openeew/openeew-sensor/pcb/legacy/eagle/openeew_sensor.pdf

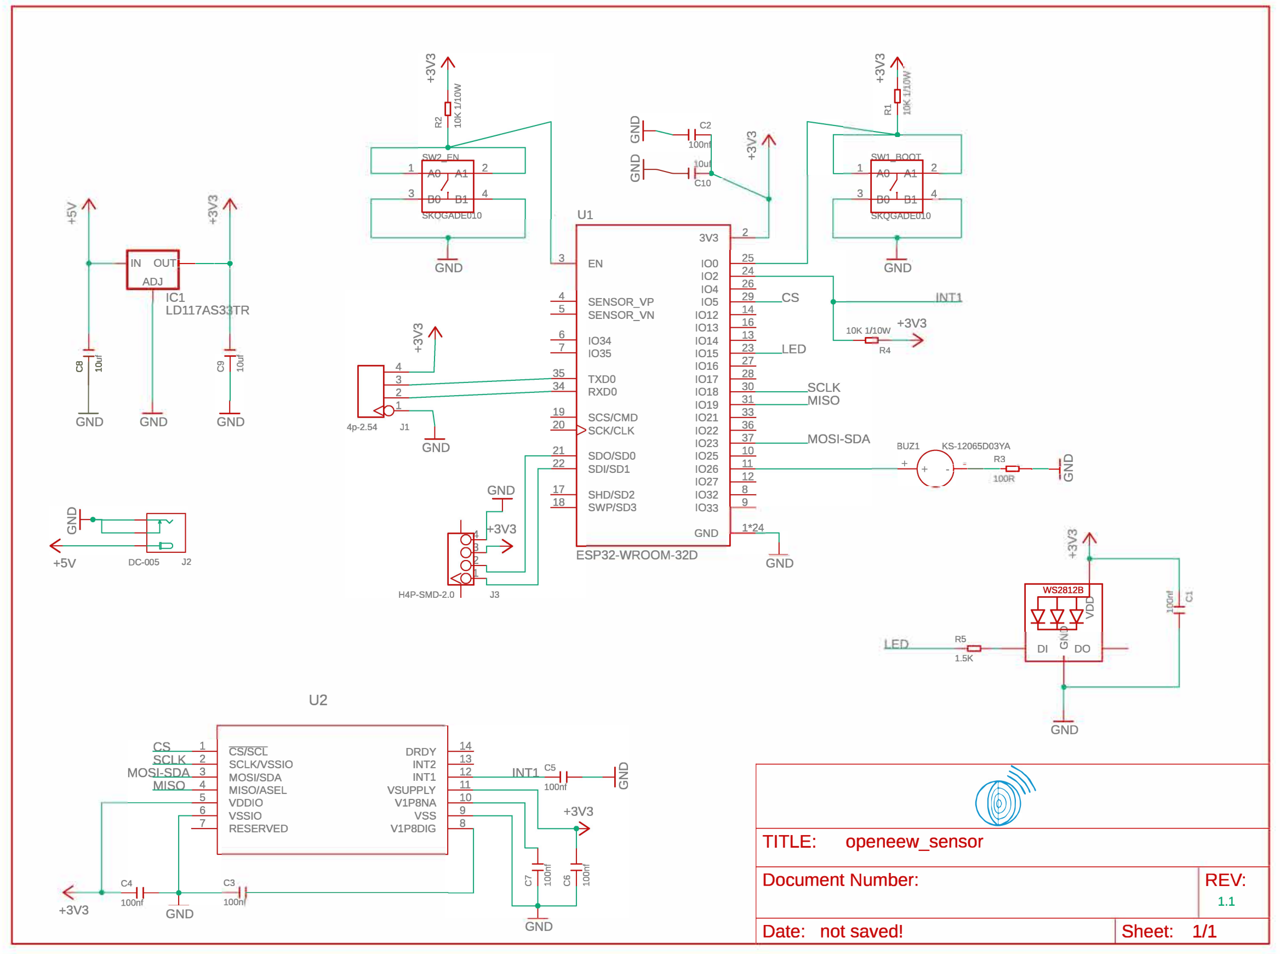
[picture p3: page 1]

'³

T?
1

GND

+5V

+3V3

IN OUTI---
ADJ

ICl
LD117AS3 TR

GND

DC-005 | J2

GND

GND

c::s7Scr
SCLK/VSSIO
MOSI/SDA
MISO/ASEL
VDDIO
VSSIO
RESERVED

C3
lOOn

U2

1

3

GND

DRDY
INT2
INTl
VSUPPLY
VlPSNA
vss
VlPSDIG

3

GND

GND

0 Ou 13 | ClO

Ul
3V3
EN | 100
| 102
| 104
SENSOR_VP | 105
SENSOR_VN | 1012
| 1013
1034 1014
1035 1015
| 1016
TXD0 | 1017
RXD0 | 1018
| 1019
SCS/CMD | 1021
SCK/CLK | 1022
| 1023
SDO/SD0 | 1025
SDI/SDl | 1026
| 1027
SHD/SD2 | 1032
SWP/SD3 | 1033
| GND

ESP32-WROOM-32D

"'

"'
+

2

1*24

GND

1

3

GND

+3V3 lOK 1/lOW

R4

0

## ¹⁻"---C>⁻--t 13

RS
DI C!> DO

1.5K

GND
ct

## TITLE: openeew _ sensor

## Document Number:

## Date: not saved!

REV:
1.1

## Sheet: 1/1
