openeew/openeew-sensor/images/case-bottom.jpg

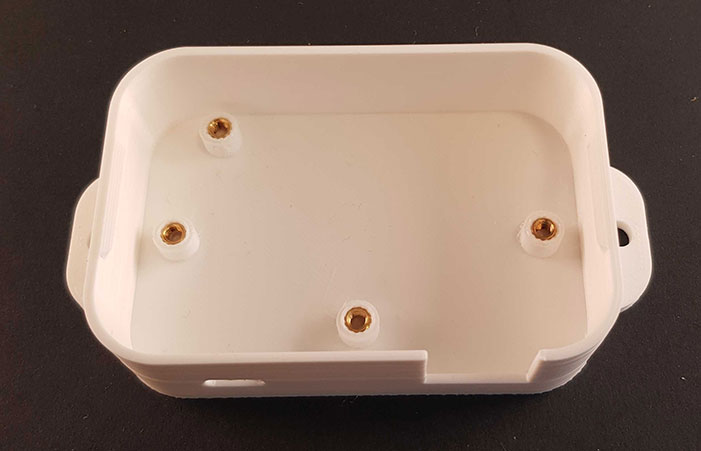
images/case-bottom.jpg
