openeew/openeew-sensor/images/case-lid.jpg

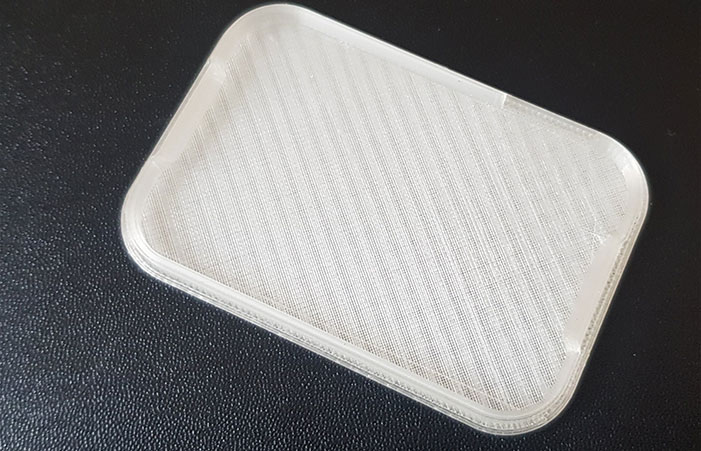
images/case-lid.jpg
