openeew/openeew-sensor/images/PCB-3d.png

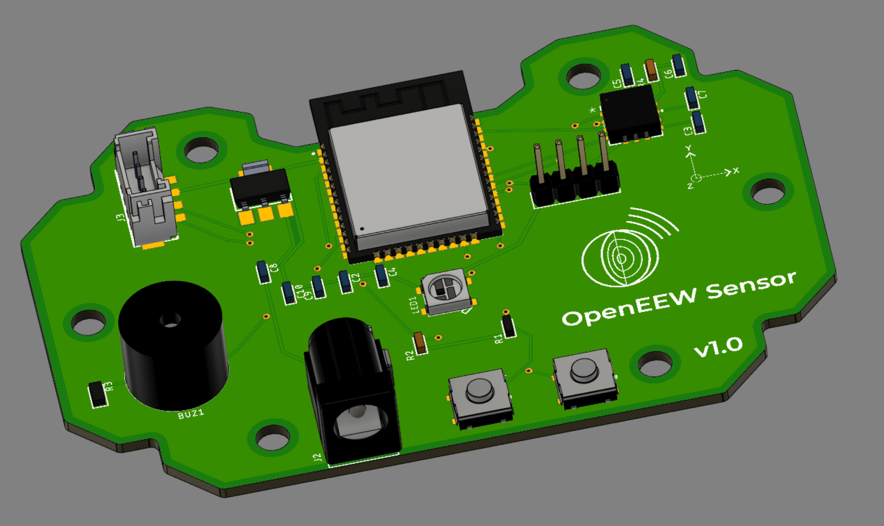
images/PCB-3d.png
