openeew/openeew-sensor/images/pcb-openeew.PNG

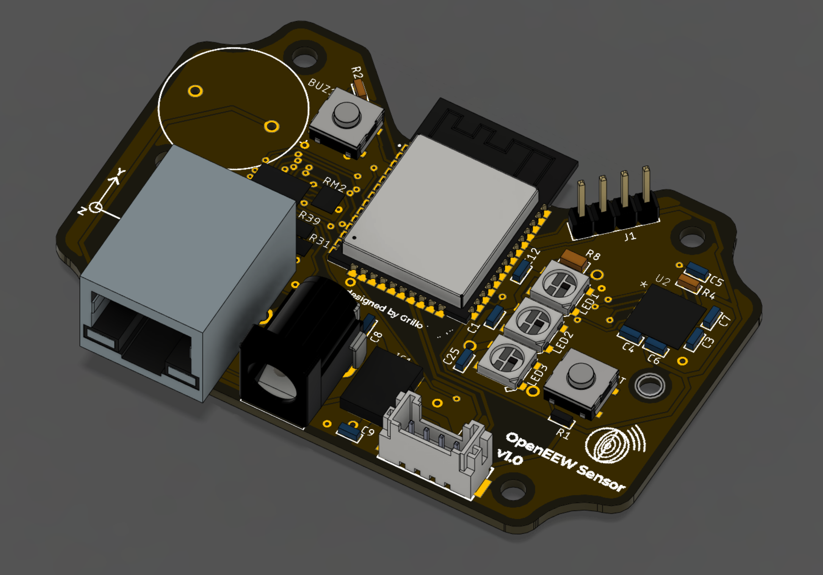
images/pcb-openeew.PNG
