openeew/openeew-sensor/images/platformio-spiffs.png

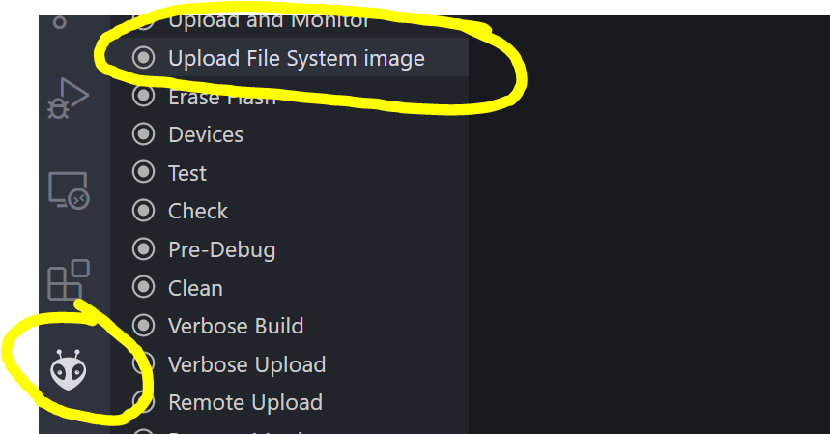
images/platformio-spiffs.png
