openeew/openeew-sensor/images/sensor-bubble-level.jpg

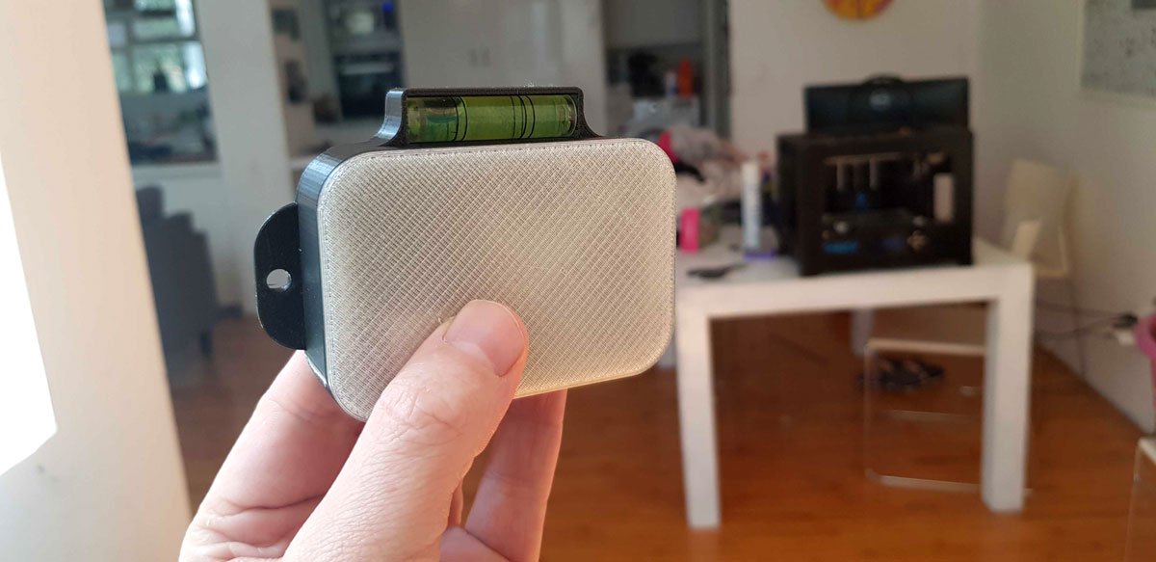
images/sensor-bubble-level.jpg
