openeew/openeew-sensor/images/sensor-case-closed.jpg

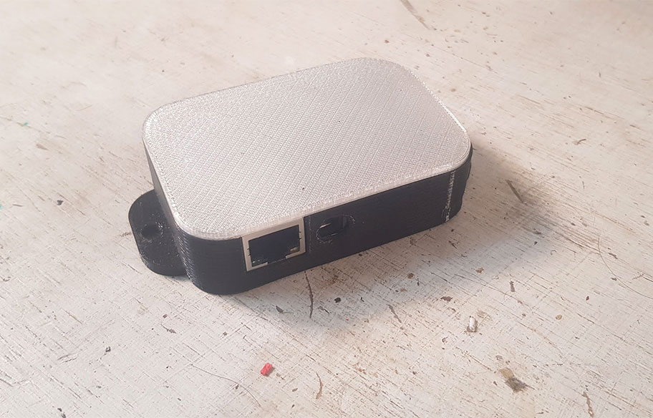
images/sensor-case-closed.jpg
