openeew/openeew-sensor/images/sensor-case-open.jpg

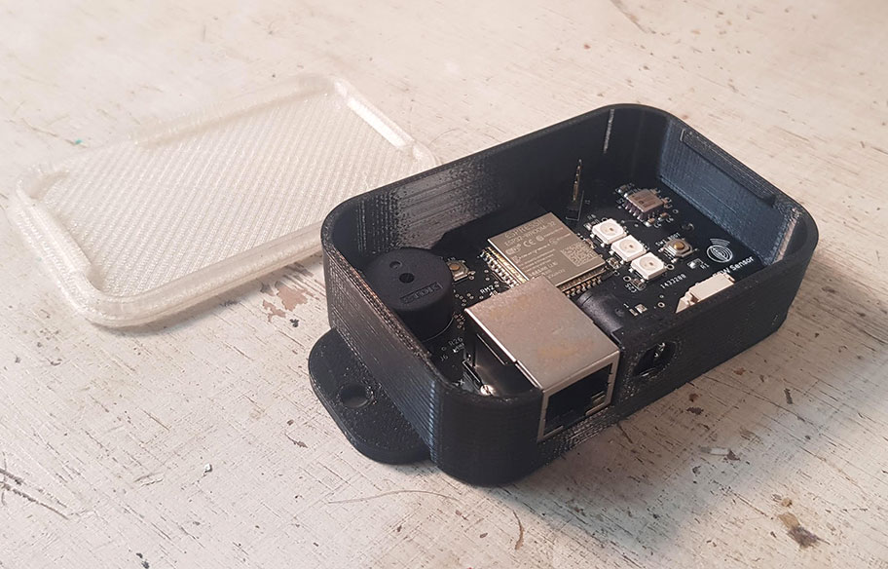
images/sensor-case-open.jpg
