openeew/openeew-sensor/images/threaded-insert.jpg

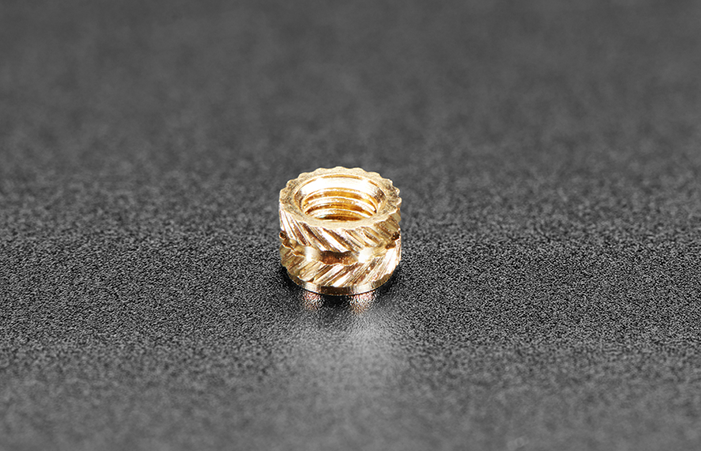
images/threaded-insert.jpg
