openeew/openeew-sensor/images/sensor-install.jpg

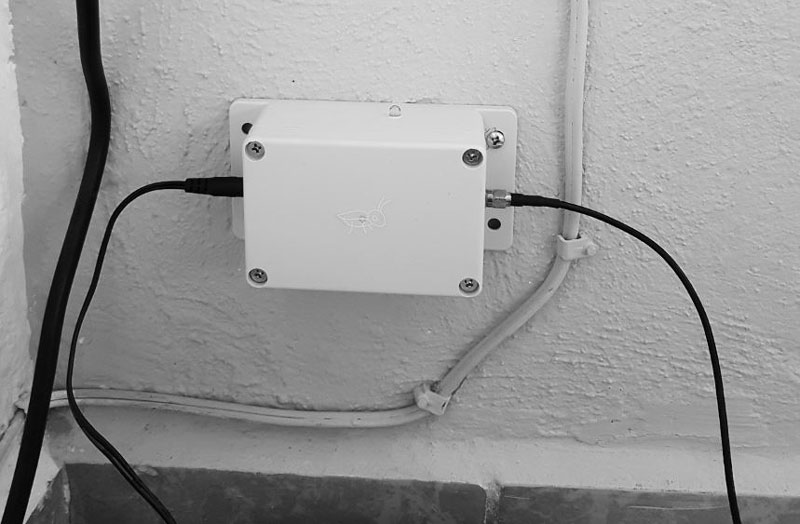
images/sensor-install.jpg
