openeew/openeew-sensor/(threads)

Thread 2 (2020-08-10):

Create new firmware branch with 'edge' processing that significantly reduces telemetry

andygrillo, 2020-08-10:
The current firmware transmits all accelerations (31.25 or 125hz) every second to the MQTT server. However more than 99% of this is not useful data because it include non-earthquake accelerations. Reducing the telemetry would also allow for new connectivity options such as LTE and CAT-M1 where every Kb sent has a cost, and therefore would open up new opportunities for installing dense networks in remote areas.

If you can help, please create a new branch for the existing [firmware](https://github.com/openeew/openeew-sensor/tree/master/firmware). This will contain many of the same features such as:
- reading FIFOs from the ADXL355
- a running average to maintain a zero-g offset
- mqtt transmission (if going cellular we could use UDP instead as the line will be secure)
- NTP functions

However it will also have new features:
- on every second (1 fifo@ 31.25hz sample rate, or 4 fifos@125hz sample rate), it will perform an STA/LTA calculation which divides the last second of data for each axis with the last 10 (to be a variable) seconds of data for each axis.
- if the output of the STA/LTA value is > x (variable to be defined in config or by MQTT subscribe on boot), then an event is determined, and the maximum acceleration ( pga ) is taken from the previous 1 second of data.
- the pga value is then added to a JSON and sent to the MQTT server with the `trigger` topic:
```
{"device_id":XXX, "lat":XXX, "lon"XXX, "time":XXX, "pga":XXX}
```

johnwalicki, 2020-12-10:
Vaclav, RUWO and John met on 12/09/2020 to discuss the STA/LTA algorithm implementation on how to detect quakes.
Here are some minutes of that discussion:
Attendees: @Vaclav Kuna @RUWO @John Walicki

- Vaclav reviewed his Python STA/LTA algorithm implementations (there is a loop technique and a Matrix math technique)
- The board needs to store 10 seconds of data [x,y,z] in some array.
- Run the algorithm on new readings (32 samples from the last second) and the prior 10 seconds.  So its really 11 seconds of data.
- Better to run the algorithm on each of the 32 new values against the prior array of values.
- John suggested that we don't think of the prior 10 seconds of data in terms of seconds, just a queue of 320 values. There are a variety of example First In First Out queue implementations on StackOverflow.
- If the result is greater than a threshold ( 3 is a good compromise but might be different for different sensors),  send the prior 10 seconds to the cloud and start sending real time accelerometer data for the next 5 seconds
- We discussed being able to adjust the Threshold via a MQTT topic on a per sensor basis.  If one sensor is located in a "noisy" environment and is throwing lots of false positives, we could tell it to up its threshold via a message sent down from the cloud.  Tabled as an advanced feature.
- Since John received a new board from Andy today, he could possibly send his old board to Belgium.  The old board has a working ESP32 and ADXL355 but other components are flakey.  Wout only needs the ESP32 and ADXL355.
- Split the project into several steps.

1. - Implement a FIFO queue that stores/manages the prior 320 readings (10 seconds)
2. - Implement a function which sends this bigger block of data via MQTT to the cloud.  (Current implement is sending 1 second at a time and would need to be modified with larger buffers)
3. - Iterate on the STA/LTA algorithm
4. - When the 10 second block of data arrives in the cloud, store it somewhere, start the alarm process?

johnwalicki, 2020-12-15:
Firmware version 1.3.0 branch is open.  I am working on the STA/LTA algorithm in v1.3.0
 https://github.com/openeew/openeew-sensor/tree/version130

johnwalicki, 2020-12-16:
Sections of code required to implement this feature are landing in the version130 branch
https://github.com/openeew/openeew-sensor/commit/6edafb81ef008fdaedcc5c6b31e546a6eef7ee26
https://github.com/openeew/openeew-sensor/commit/abc14a942d50beb9063b6852034a630a77cf11ad

johnwalicki, 2020-12-23:
When sending 10 seconds of accelerometer data to the cloud, it should really include timestamps.  Currently the two patches in this feature just store the prior 10 seconds of accelerometer X,Y,Z data in a FIFO queue of 320 readings ( 32 readings/second x 10 seconds ).  Time is relative to "now", there's no absolute timestamp. When we transmit and subsequently store the data in the cloud database for later analysis, there's no reference point.  I need to add timestamps to the FIFO queue.

Note that the 32 readings are sampled once per second so the timestamp accuracy is going to be slightly off. Since the order of samples is preserved, the analysis could spread the samples "across" that trailing second.

Note its a trailing second.  the program will record the timestamp when it reads the ADXL355 buffer (which contained the prior second's worth of data)  That timestamp will be the prior 32 samples.

andygrillo, 2020-12-23:
To be discussed with Vacalv, but potentially we can omit the device
timestamp and add a timestamp when its been ingested in the cloud. As
device>cloud latency is typically less than 1/2s, it should be ok.

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

--
Andres Meira
*m* +52 (55) 12246468
*skype *andresmeira

johnwalicki, 2021-02-19:
Firmware v1.3.0 has been published
This Issue has been closed via https://github.com/openeew/openeew-sensor/pull/61

Closed 2021-02-19.

Thread 3 (2020-08-12):

BOM and PCB files missing

frankenstein91, 2020-08-12:
As far as I can see, only the circuit diagram is currently available, but the BoM and PCB files are still missing.
But these files are already referred to in the documentation and on the website.

krook, 2020-08-12:
@andygrillo

andygrillo, 2020-08-12:
@frankenstein91 @krook yes sorry we only had a PDF schematic. Please look now- I added the eagle files :)

andygrillo, 2020-08-12:
For now you can generate the BOM from the eagle schematic. I will clean up the BOM I have here and upload later today.

hildogjr, 2020-08-13:
How about using [KiCad](https://kicad-pcb.org/) as free schematic/layout software? There is also [tool for cost BOM](https://pypi.org/project/kicost/) .

andygrillo, 2020-08-13:
Yes I suppose we should stick to open source (although eagle is free for this size of board).

we used eagle because we were comfortable, but if you are ok with doing this board in Kicad, that would be awesome.

chronopoulos, 2020-08-13:
+1 for kicad

gimbas, 2020-08-13:
Would there be interest in a project conversion to Kicad? I want to contribute.

andygrillo, 2020-08-13:
If you are willing to do this (great!), I will list out here my findings from testing the current board that we just got  back from China. The important functions seem good (still testing), i.e. ESP32, UART interface, Ethernet, and most importantly SPI connection with ADXL355.

However would be good to take a look at the WS2812b circuit as I'm not able to get anything other than white right now using the Neopixels sample code, and there is a flicker with the brightness.

The UART header + 5v dc jack should probably be replaced with a USB port (type C). The issue is that some follks may not have a 3.3v FTDI module lying around - will make programming easier.

gimbas, 2020-08-13:
Starting to work on it right away, there are some things that warrant some discussion, where should that happen?

krook, 2020-08-13:
@gimbas The #sensors channel in Slack would probably be the right place.

hildogjr, 2020-08-13:
I would propose to add "manf#" field to each part for the Manufacture Part Number. We can use it by [KiCost](https://pypi.org/project/kicost/) for generate a automatic cost BOM.

andygrillo, 2020-08-29:
> I would propose to add "manf#" or "mpn" field to each part for the Manufacture Part Number. We can use it by [KiCost](https://pypi.org/project/kicost/) for generate a automatic cost BOM.

Thats a great idea @hildogjr  - please can you suggest this in a new issue ?

Closed 2020-08-31.

Thread 4 (2020-08-12):

Add method for including latitude and longitude of sensor to msgs for /device topic

andygrillo, 2020-08-12:
In previous iterations of the Grillo sensor we included GPS modules. However we have not included them in the sensor hardware to save cost, to make it easier to install away from windows, and because NTP time is accurate enough for EEW.

However we now need a new way to pass on the location of each sensor in the `/device` topic message.

I suggest we avoid using Google Geolocation API as this incurs a cost. Instead we can pass on the lat/lon coordinates using the ESP32 smart config protcol. This is already used to send wifi credentials - why cant it also be used to send lat/lon coordinates of phone ?

Potentially we can create a new iteration of the ESPTouch mobile app which sends this data using https://pub.dev/packages/esptouch_flutter, and then modify the firmware to receive these new values.

johnwalicki, 2020-11-12:
I found a simple API that will give you Lat,Lng
https://ipstack.com/documentation
I signed up for a free apikey that allows for 10K msgs / month
The API  was simple to call and it returns a json object that includes Lat,Lng
http://api.ipstack.com/check?access_key=<myapikey>

johnwalicki, 2020-11-12:
I envision, at every device powerup, it calls this location API and figures out where it is.
Sends a "Device Activated" message to some restful "Onboarding" interface in the Cloud.
The message includes WiFi, Ethernet mac addresses and Lat,Lng
The response from our centralized "Onboarding" API would include the MQTT host it should connect to.
"Oh, your device is in [Nepal,New Zealand,Mexico,Carribean,etc] return a Watson IoT Platform MQTT instance close to me"

andygrillo, 2020-11-12:
Sounds great, excellent way to route devices to endpoints.

Ill look at this servie tomorrow. My concern is if it works simply by the
ip address. We tries this before and it regularly got the address wrong by
hundreds of meters and in one case in another state. This would have a big
impact on the detection. But maybe we coukd get the user to confirm the
address somehow?

On Wed, Nov 11, 2020, 11:07 PM John Walicki <notifications@github.com>
wrote:

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

johnwalicki, 2020-11-12:
Agree that it might not be 100% accurate but it gets really close.  In my case, it put the map pin directly in front of my house.

johnwalicki, 2020-11-23:
A mobile application might need to assist in more accurate geolocation.  In the OpenEEW #apps slack channel, we've been discussing using Flutter / SmartConfig / Device registration panels that can send email and location to the cloud so that we can link the device WiFi mac address to an owner / place.

johnwalicki, 2020-12-13:
The mobile OpenEEW Provisioning app sends the smartphone GPS coords as part of the user details registration.
This information is stored in the Cloudant DB.
See https://github.com/openeew/openeew-provisioner/blob/main/PROVISIONING.md

The possible risk is that devices get activated somewhere NOT where they will be positioned.
@andygrillo  is that sufficient?

andygrillo, 2020-12-13:
I suspect this is fine. Later on we could discuss adding a verification
step where the address is sent back to the user, or the user has to confirm
the location on the dashboard ?

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

--
Andres Meira
*m* +52 (55) 12246468
*skype *andresmeira

johnwalicki, 2020-12-13:
Thinking through the wifi set-up, the device might be activated, using the Mobile app, on one network,  that location would be written to Cloudant db. Then,  when the device moves, the new wifi network said/password will likely be different. The mobile app would be used, call SmartConfig and also adjust/overwrite the device location in the Cloudant db.

Closing issue

Closed 2020-12-13.

Thread 6 (2020-08-13):

PoE module plugin

andygrillo, 2020-08-13:
Would be good to have the option to add a PoE module that could be plugged in. This would allow for installation in commercial environments with only an ethernet cable connecting the sensor.

I know its been discontinued, but as an example this seemed to work well :
https://github.com/particle-iot/ethernet-wing

perigoso, 2020-09-06:
I never played with PoE, so I was unfamiliar with it. But I've been doing some research and learning about it so I might be able to implement it in the near future, for now though  I think i detected our first problem with it, our current Ethernet connector is not made with PoE in mind so I think it's not possible to do it with it, we need to look for an alternative.

andygrillo, 2020-09-06:
Good find. Our ethernet circuit is based on an Olimex ESP32 board. I
believe they also have a PoE version so I'll see what components they use
there.

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

perigoso, 2020-09-06:
Olimex does have some very good reference material, i think this is a good guideline: [ESP32-POE-ISO](https://www.olimex.com/Products/IoT/ESP32/ESP32-POE-ISO/open-source-hardware)

andygrillo, 2020-09-07:
Oh very nice :) They have kicad files also https://github.com/OLIMEX/ESP32-POE-ISO/tree/master/HARDWARE/ESP32-PoE-ISO-Rev.D

Thread 7 (2020-08-17):

Send meta data message on boot to /device topic

andygrillo, 2020-08-17:
When the device boots up, it should send a message to `device` MQTT topic containing device ID, latitutde, longitude, firmware version, device type and time.

An example would be:
```{device_id: 2351n2x55, latitude: 19.35, longitude: -99.14, firmware_version: 1.2, device_type: esp32, time_entered: 1597685615}```

This message will become a row in the database - see the corresponding table structure [here](https://github.com/openeew/openeew-detection/blob/master/init_db.sql).

johnwalicki, 2020-11-16:
I've added an OpenEEW Device Activation endpoint to the firmware.  This isn't a MQTT message because the board doesn't know where to send its MQTT data until the endpoint replies with the MQTT broker.   The HTTP post from the board to the endpoint running in IBM Cloud, includes
```{"macaddress":"112233445566","lat":40,"lng":-74,"firmware_device":"1.0.0"}```

johnwalicki, 2020-11-16:
Not exactly the original request, but very close to the intended purpose.  I think this GitHub issue can be closed via
https://github.com/openeew/openeew-sensor/pull/43
https://github.com/openeew/openeew-sensor/pull/44
https://github.com/openeew/openeew-sensor/pull/45

johnwalicki, 2020-11-16:
The IBM Cloud side of the new OpenEEW Device Activation endpoint stores the new device details in a Cloudant DB and in Watson IoT Platform metadata.

johnwalicki, 2020-11-23:
Closing issue - implemented via the Device Activation techniques described above.

Closed 2020-11-23.

Thread 8 (2020-08-17):

Change RMII pins in Kicad layout

andygrillo, 2020-08-17:
The TXD1 pin from the ESP32 should go to the TXD1 pin in the LAN8720 module.
Similarly, the TXD0 pin should also go to the TXD0 pin in the LAN8720.

Currently we have these crossed:
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

Its not possible to reassign these pins in code because the ESP32 has a fixed RMII bus, so the wiring must be done correctly.

perigoso, 2020-08-17:
This was one thing in particular that i wanted to ask when i ported the schematic, makes sense now.

andygrillo, 2020-08-17:
Yes, was our mistake. Its a shame because we wanted to test the LAN8720

perigoso, 2020-08-19:
Check If this is the only erroneous connection in the RMII

Closed 2020-08-19.

Thread 12 (2020-08-29):

Rev 1.0 hardware issues

perigoso, 2020-08-29:
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

This is issue is meant to keep track of these issues and related fixes

andygrillo, 2020-08-29:
Great idea. Thanks @perigoso this way it doesn't get lost in slack :)

perigoso, 2020-08-31:
I wanted to ask about this circuit? what exactly is it trying to achieve, and where did you get it from?

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

perigoso, 2020-08-31:
Changed the level shifting on the WS2812B LEDs to a schmit-trigger buffer, this avoids the inversion of the data line, and should provide clean edges (i believe one these was the cause for the issues).

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

perigoso, 2020-08-31:
Changed the Buzzer driving circuit

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

@andygrillo If you want to test the buzzer with the current revision try changing the resistor in series with the buzzer for a 0 ohm / short, and change the transistor base resistor for a value around 1k, you should be able to get some sound out of it.

andygrillo, 2020-08-31:
> I wanted to ask about this circuit? what exactly is it trying to achieve, and where did you get it from?
>

Hi @perigoso , the guy who designed this based the ethernet circuit on the Olimex esp32 board: https://www.olimex.com/Products/IoT/ESP32/ESP32-EVB/  - here you can find the link to the schematic pdf which he worked from.

andygrillo, 2020-09-03:
@perigoso when you receive the board, would you be capable rerouting 2 RMII connections between the LAN8710 and ESP32 ?

I think we need to cut traces between TXD1 > TXD0, and TXD0 > TXD1, then connect with new wires so that TXD1 > TXD1 and TXD0 > TXD0 ?

I have tried but the traces are very small and I don't have a microscrope/my eyes aren't good enough....

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

perigoso, 2020-09-03:
@andygrillo I was already planning on doing so! should not be an issue

andygrillo, 2020-09-03:
If you success pls tell me how you did it! its so small I can't even use a normal solid wire between the pads

andygrillo, 2020-09-03:
Also, you'll need an FTDI 3.3v to program it, which I suspect you would already have

gareth2020, 2020-09-11:
We can work with the Plated Though Holes (PTH)s on the underside.
3 tracks are visible on the underside from PTHs under the esp32 to PTHs near the PHY.
We can bare two of those tracks with a scalpel.
We can cut the two tracks with a scalpel and then solder new wires to cross over the connections.

Numbering the holes under the esp32 from top to bottom as h1,h2,h3,
Numbering the holes next to the PHY from top to bottom as p1,p2,p3

On V1.0 pcb
h1 is connected to p1 by a long track
h2 is connected to p2 by a long track
h3 is connected to p3 by a long track

h1 does not matter
h2 seems to be connected to pin 36 of esp32 (IO22 = EMAC_TXD1)
h3 seems to be connected to pin 31 of esp32 (IO19 = EMAC_TXD0)

In the following part of the top view:
p1 is connected to pin 21 of the PHY (TXEN)
p2 is connected to pin  22 of the PHY (TXD0) 
p3 is connected to pin  23 of the PHY (TXD1)
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

perigoso, 2020-09-22:
Quick update, after the rework the board seems to work as expected
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

```
ETH Disconnected
ETH Connected

ETH MAC: 24:6F:28:CC:E8:A3, IPv4: 192.168.1.69, FULL_DUPLEX, 100Mbps
connecting to google.com
HTTP/1.1 301 Moved Permanently
Location: http://www.google.com/
Content-Type: text/html; charset=UTF-8
Date: Tue, 22 Sep 2020 00:07:10 GMT
Expires: Thu, 22 Oct 2020 00:07:10 GMT
Cache-Control: public, max-age=2592000
Server: gws
Content-Length: 219
X-XSS-Protection: 0
X-Frame-Options: SAMEORIGIN

<HTML><HEAD><meta http-equiv="content-type" content="text/html;charset=utf-8">
                                                                              <TITLE>301 Moved</TITLE></HEAD><BODY>
                                                                                                                   <H1>301 Moved</H1>
               The document has moved
                                     <A HREF="http://www.google.com/">here</A>.
</BODY></HTML>
closing connection
```

andygrillo, 2020-09-22:
great work!

andygrillo, 2020-09-22:
for reference, here is the ethernet test program:
```
/*
    This sketch shows how to configure different external or internal clock sources for the Ethernet PHY
*/
#include <ETH.h>
/*
   * ETH_CLOCK_GPIO0_IN   - default: external clock from crystal oscillator
   * ETH_CLOCK_GPIO0_OUT  - 50MHz clock from internal APLL output on GPIO0 - possibly an inverter is needed for LAN8720
   * ETH_CLOCK_GPIO16_OUT - 50MHz clock from internal APLL output on GPIO16 - possibly an inverter is needed for LAN8720
   * ETH_CLOCK_GPIO17_OUT - 50MHz clock from internal APLL inverted output on GPIO17 - tested with LAN8720
*/
#ifdef ETH_CLK_MODE
#undef ETH_CLK_MODE
#endif
#define ETH_CLK_MODE ETH_CLOCK_GPIO17_OUT
//#define ETH_CLK_MODE ETH_CLOCK_GPIO0_IN
//#define ETH_CLK_MODE ETH_CLOCK_GPIO0_OUT
// Pin# of the enable signal for the external crystal oscillator (-1 to disable for internal APLL source)
#define ETH_POWER_PIN   -1
// Type of the Ethernet PHY (LAN8720 or TLK110)
#define ETH_TYPE        ETH_PHY_LAN8720
// I²C-address of Ethernet PHY (0 or 1 for LAN8720, 31 for TLK110)
#define ETH_ADDR        0
// Pin# of the I²C clock signal for the Ethernet PHY
#define ETH_MDC_PIN     23
// Pin# of the I²C IO signal for the Ethernet PHY
#define ETH_MDIO_PIN    18
static bool eth_connected = false;
void WiFiEvent(WiFiEvent_t event) {
  switch (event) {
    case SYSTEM_EVENT_ETH_START:
      Serial.println("ETH Started");
      //set eth hostname here
      ETH.setHostname("esp32-ethernet");
      break;
    case SYSTEM_EVENT_ETH_CONNECTED:
      Serial.println("ETH Connected");
      break;
    case SYSTEM_EVENT_ETH_GOT_IP:
      Serial.print("ETH MAC: ");
      Serial.print(ETH.macAddress());
      Serial.print(", IPv4: ");
      Serial.print(ETH.localIP());
      if (ETH.fullDuplex()) {
        Serial.print(", FULL_DUPLEX");
      }
      Serial.print(", ");
      Serial.print(ETH.linkSpeed());
      Serial.println("Mbps");
      eth_connected = true;
      break;
    case SYSTEM_EVENT_ETH_DISCONNECTED:
      Serial.println("ETH Disconnected");
      eth_connected = false;
      break;
    case SYSTEM_EVENT_ETH_STOP:
      Serial.println("ETH Stopped");
      eth_connected = false;
      break;
    default:
      break;
  }
}
void testClient(const char * host, uint16_t port) {
  Serial.print("\nconnecting to ");
  Serial.println(host);
  WiFiClient client;
  if (!client.connect(host, port)) {
    Serial.println("connection failed");
    return;
  }
  client.printf("GET / HTTP/1.1\r\nHost: %s\r\n\r\n", host);
  while (client.connected() && !client.available());
  while (client.available()) {
    Serial.write(client.read());
  }
  Serial.println("closing connection\n");
  client.stop();
}
void setup() {
  Serial.begin(115200);
  WiFi.onEvent(WiFiEvent);
  ETH.begin(ETH_ADDR, ETH_POWER_PIN, ETH_MDC_PIN, ETH_MDIO_PIN, ETH_TYPE, ETH_CLK_MODE);
}
void loop() {
  if (eth_connected) {
    testClient("google.com", 80);
  }
  delay(10000);
}```

perigoso, 2020-09-22:
I got the buzzer to output sound, i have no way to measure but it's not too loud, some optimizations can be done.

[I posted a video on slack](https://openeew.slack.com/archives/C014ZP4AM4H/p1600812352049000)

The test code for reference:
```
int freq = 4000;
int channel = 0;
int resolution = 8;
int io = 32;

void setup() {
  ledcSetup(channel, freq, resolution);
  ledcAttachPin(io, channel);

  ledcWriteTone(channel, freq);
  ledcWrite(channel, 125);
}

void loop() {

}

```

perigoso, 2020-09-22:
Leds seem to work as desired after the proposed changes.

[video on slack](https://openeew.slack.com/files/U019H72A2LQ/F01B0756AB0/vid_20200923_004521_ls.mp4)

the rework:
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

the test code:
```
#include <Adafruit_NeoPixel.h>

#define LED_PIN 16
#define LED_COUNT 3

//Adafruit_NeoPixel pixels = Adafruit_NeoPixel(LED_COUNT, LED_PIN, NEO_GRB + NEO_KHZ800);
Adafruit_NeoPixel strip(LED_COUNT, LED_PIN, NEO_GRB + NEO_KHZ800);
//   NEO_KHZ800  800 KHz bitstream (most NeoPixel products w/WS2812 LEDs)
//   NEO_KHZ400  400 KHz (classic 'v1' (not v2) FLORA pixels, WS2811 drivers)
//   NEO_GRB     Pixels are wired for GRB bitstream (most NeoPixel products)
//   NEO_RGB     Pixels are wired for RGB bitstream (v1 FLORA pixels, not v2)
//   NEO_RGBW    Pixels are wired for RGBW bitstream (NeoPixel RGBW products)

void setup()
{
//pixels.begin(); // This initializes the NeoPixel library.
  strip.begin();
  strip.show(); // Initialize all pixels to 'off'
}

void loop()
{
    for (int i = 0; i < 2; i++) {
    for (int j = 0; j < 2; j++) {
    for (int k = 0; k < 2; k++) {
    for (int l = 0; l < 3; l++) {
        strip.setPixelColor(l, strip.Color(i * 255, j * 255, k * 255)); // Moderately bright green color.
        strip.show(); // This sends the updated pixel color to the hardware.
        delay(200); // Delay for a period of time (in milliseconds).
    }}}}
}
```

Closed 2020-09-23.

Thread 14 (2020-08-31):

Add MPN for each componet

hildogjr, 2020-08-31:
I am one of the developer of [KiCost](https://github.com/xesscorp/KiCost/) and contributor (icon designed) of [iBOM](https://github.com/openscopeproject/InteractiveHtmlBom). Both python tools designed to work with KiCad.

About KiCost, it is a Python tool, that using the Manufacture Part Number (MPN) of the components, generate a full *cost* spreadsheet of your Board BOM in several web distributors.

This issue is related with #3. I propose to create a MPN field at KiCad project to store the MPN/mpn/manf# (or other string variant wiht same mean) of each part. This will possibility us to get the better price for the project production.

Thread 15 (2020-08-31):

Enclosure Files

perigoso, 2020-08-31:
Sharing G-code is not ideal, it is machine specific, in general github should be used with source files, and avoid compiled files, generated files, binaries, etc.

I propose the models be uploaded on STL and perhaps STEP format only.

perigoso, 2020-08-31:
Noting, STL and STEP files are akin to binaries, but it is the closest we get for a source file for this.

andygrillo, 2020-08-31:
ahh yes, my mistake. I will correcvt.

andygrillo, 2020-08-31:
done https://github.com/openeew/openeew-sensor/tree/master/enclosure

Closed 2020-08-31.

Thread 16 (2020-09-03):

Add alarm function

andygrillo, 2020-09-03:
Add MQTT subscribe function that interrupts the main loop when an alarm message is received.

johnwalicki, 2020-09-30:
I'm looking at implementing this alarm topic in the OpenEEW firmware / Watson IoT Platform implementation

johnwalicki, 2020-11-26:
- Andy posted a sample sketch in the firmware slack channel today that exercises the buzzer on the production board.
- Add that example into the Alarm topic callback so that we can send Alarm alerts from the cloud to the devices and warn of impending quakes.
- Build a sample Node-RED flow that publishes to the Alarm topic

johnwalicki, 2020-12-20:
version130 branch has a very simplistic alarm function that sounds the buzzer when the ESP32 receives an earthquake MQTT topic.
https://github.com/openeew/openeew-sensor/commit/6928ee0ae6397e37abbbe023f37046f5d725f54a

johnwalicki, 2021-02-19:
Firmware v1.3.0 has been published
This Issue has been closed via https://github.com/openeew/openeew-sensor/pull/61

Closed 2021-02-19.

Thread 17 (2020-09-08):

Missing bypass capacitors on the accelerometer chip power supply and voltage reference pins.

gareth2020, 2020-09-08:
The noise performance might be worse than the specification because of missing bypass capacitors on the accelerometer chip power supply and voltage reference pins.

Figure 59 in https://www.analog.com/media/en/technical-documentation/data-sheets/adxl354_adxl355.pdf  suggests 2 bypass capacitors should be used for each power supply near to the ADXL355. i.e. 0ne 0.1uF (100nF) capacitor and one 1 uF capacitor.  However the OpenEEW schematic only seems to show 100nF capacitors connected to pins 5,8,10 and 11 of U3.
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

Analog Devices, probably characterized the noise spectral density for ±2 g range as 22.5 μg/√Hz
by using the circuit shown in Figure 59 of https://www.analog.com/media/en/technical-documentation/data-sheets/adxl354_adxl355.pdf. If the 1u F capacitors are not present, then the noise spectral density might be worse and the signal might be less immune to power supply noise e.g. from other electrical activity on the pcb and from radio frequency interference and from noise on the 5V power input.

For more on why two capacitors per voltage pin (and how to place and rout them) see https://www.analog.com/media/en/training-seminars/tutorials/MT-101.pdf
e.g. "Low  frequency  noise  requires  larger  electrolytic  capacitors  which  act  as  charge  reservoirs  to  transient  currents.  High  frequency  power  supply  noise  is  best  reduced  with  low  inductance  surface  mount  ceramic  capacitors  connected  directly  to  the  power  supply  pins  of  the  IC. "
e.g. "The purpose of the large capacitor is to be a reservoir of charge to supply the instantaneous charge requirements of the circuits locally so the charge need not come through the inductance of the power trace"

Reliability of the OpenEEW sensor might also be improved with two capacitors per voltage pin because when one of the capacitors fails it might not causing too much damage to the noise performance. If there was only one capacitor then the noise performance might be damaged too much if it failed.

gareth2020, 2020-09-08:
It is hard to tell if the loss of noise performance and immunity will matter in this application. It might not because most local noise will not correlate between sites.

It is also interesting to note that the Analog Devices evaluation board has two capacitors per voltage pin but they are not different.  See https://wiki.analog.com/_media/resources/eval/user-guides/301-736_adxl355z_evaluation_board_rev_2_-_schematic.pdf

gareth2020, 2020-09-08:
There is another eval board https://wiki.analog.com/_media/resources/eval/user-guides/eval-adicup360/hardware/adxl355/02_043217b_top.pdf   which has 10uF and a 0.1uF connected to each supply pin:
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

gareth2020, 2020-09-08:
We could see if adding a 1uF capacitor or a 10 uF capacitor has any affect on the noise amplitude in the /sensor-traces?orgId=2&refresh=5s

perigoso, 2020-09-23:
Reopened, there are still some tests that can be done

andygrillo, 2020-09-23:
@perigoso you mean testing the board as we have it now without bypass capacitors, against a revision with the bypass capacitors ?

perigoso, 2020-09-23:
there was mention of experimenting with 1uF and 10uF, that's what i meant.
though imo there isn't really a need for this

gareth2020, 2020-09-24:
The analog supply to the ADXL355 needs a ferrite in the analog return path as well to create a clean AGND .  AGND is also where the capacitors connected to V1PANA and VSUPPLY should be connected. See https://wiki.analog.com/_media/resources/eval/user-guides/eval-adicup360/hardware/adxl355/02_043217b_top.pdf
Layout advice is given in https://www.analog.com/media/en/training-seminars/tutorials/MT-101.pdf

I have the two EVAL-ADXL355-PMDZ boards if looking at it will help.

perigoso, 2020-10-26:
I think we can close this, If we end up doing further testing or find issues we can take a further look, but for now this should be resolved.

Closed 2020-10-28.

Thread 18 (2020-09-08):

add certificates for secure TLS/SSL connection with MQTT broker

andygrillo, 2020-09-08:
Allow the option of using MQTT certificates for secure connection to the server:

http://www.iotsharing.com/2017/08/how-to-use-esp32-mqtts-with-mqtts-mosquitto-broker-tls-ssl.html
http://www.steves-internet-guide.com/creating-and-using-client-certificates-with-mqtt-and-mosquitto/

These certificates would need to be loaded into the SPIFFS memory of the ESP32

johnwalicki, 2021-03-30:
Firmware v1.4.0 included the Watson IoT Server certificate.
For remote subscribed MQTT topics, that certificate allows the device to confirm the MQTT messages were from a trusted host.
Closing this Issue.  If we want to generate client certificates, open a new GitHub issue in the openeew/firmware repo.

Closed 2021-03-30.

Thread 25 (2020-09-29):

Create final Kicad schematic for V1

andygrillo, 2020-09-29:
- ETH pins correct
- BUZZ pin change (for GPS serial)
- INT pin change (for GPS serial)
- add GPS serial header

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

perigoso, 2020-09-29:
[pcb.pdf](https://github.com/openeew/openeew-sensor/files/5301983/pcb.pdf)

Closed 2020-10-07.

Thread 26 (2020-09-29):

Create Kicad layout V1 design based on schematic

andygrillo, 2020-09-29:
Based on schematic https://github.com/openeew/openeew-sensor/issues/25

Using Arrow components where possible to allow us to make the boards at a discounted price.

Use SMT components that a MC-385V2V PnP can use : 0201 components to 100x150mm components

andygrillo, 2020-09-29:
We need to take care of the signal integrity of REF_CLK in the hardware design! Keep the trace as short as possible. Keep it away from RF devices. Keep it away from inductor elements.

https://docs.espressif.com/projects/esp-idf/en/latest/esp32/api-reference/network/esp_eth.html

Closed 2020-10-24.

Thread 30 (2020-09-29):

Select 31.25hz as default sample rate for accelerometer

andygrillo, 2020-09-29:

johnwalicki, 2020-10-01:
I have set the default ADXL355 sample rate to 31.25hz in my branch of the sensor firmware

andygrillo, 2020-10-01:
Perfect. When you add your code we can close this

johnwalicki, 2020-11-12:
Done in https://github.com/openeew/openeew-sensor/commit/743c799804bbe61c976c1379f9a6a67a29fad67d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

Closed 2020-11-12.

Thread 31 (2020-09-29):

Add OTA feature to the firmware

andygrillo, 2020-09-29:

johnwalicki, 2020-11-23:
The original title of this GitHub issue was "Add OTA feature > to OpenEEW detection-docker"
Let's break that into two topics.  First let's work on OTA Firmware Upgrades. Then let's worry about docker.
I've changed the title.

johnwalicki, 2020-11-23:
The current firmware checks during device activation if a newer version of firmware is available.  That check works but doesn't yet invoke the OTA upgrade.

johnwalicki, 2020-11-23:
I've been reading the OTA documentation at
https://docs.espressif.com/projects/esp-idf/en/latest/esp32/api-reference/system/ota.html

johnwalicki, 2020-11-26:
Complete - Merged - Closing via PR #50

Closed 2020-11-26.

Thread 40 (2020-11-06):

Create getting started booklet

andygrillo, 2020-11-06:
To be included with OpenEEW sensors. This will provide instructions on how to provision the device, connect it to the cloud, and get going.

Ideally would be small to fit in a box with the device (10x10cm), and be in black and white so anyone can print this at home.

Closed 2021-12-29.

Thread 52 (2020-12-04):

Program RGB Leds for debugging

andygrillo, 2020-12-04:
This is a discussion for what the LEDs could indicate on the sensor board, to help users understand the status of the device.

**Connection indicators**
- [ ] breathing DIM CYAN: searching for WiFi
- [ ] static DIMCYAN: connected to WiFi
- [ ] breathing DIM PURPLE: can't connect to Wifi
- [ ] blinking DIM BLUE: everytime a msg is sent to cloud (1s)

**Alarm indicators** (fast blinking) - colors to be based on [modified Mercalli scale] (https://www.usgs.gov/media/images/modified-mercalli-intensity-mmi-scale-assigns-intensities)
- [ ] blinking BRIGHT RED: strong shaking expected here
- [ ] blinking BRIGHT ORANGE: medium shaking expected here
- [ ] blinking BRIGHT GREEN: weak shaking expected here

**Other indicators**
- [ ] 3 blinks YELLOW: (during setup loop by confirming with accelerometer values) - device is properly installed horizontally on vertical surface

johnwalicki, 2020-12-04:
In this initial [Blink NeoPixel LED Status stages commit](https://github.com/openeew/openeew-sensor/commit/9c455e9434fc359a945d849a01808d64c77beaf4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) from several weeks ago, I emulated the Particle Photon color indicators from
https://docs.particle.io/tutorials/device-os/led/photon/

johnwalicki, 2020-12-04:
I like your LED color proposals.

johnwalicki, 2021-02-19:
Firmware v1.3.0 has been published
This Issue has been closed via https://github.com/openeew/openeew-sensor/pull/61

Closed 2021-02-19.

Thread 55 (2020-12-10):

resync time on long running sensors

johnwalicki, 2020-12-10:
Sensors might be running for many weeks / months and the time on the ESP32 might drift.
At power up, the ESP32 syncs its time.  That allows it to connect to MQTT TLS.
That's great but weeks later the time might have drifted.
We should implement a periodic NTP sync.  Maybe once a day?
There already is a SetTimeESP32() function that would be called.
Implementation would be an unsigned integer counter in the loop() that just counts up to 86400 and calls the SetTimeESP32() function.

andygrillo, 2020-12-10:
Yes great idea. Could it be more frequent, say every hour? Drift over one
day could be 10s or more...

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

johnwalicki, 2021-03-30:
Closing this ticket via
https://github.com/openeew/openeew-firmware/issues/1

Closed 2021-03-30.

Thread 56 (2020-12-10):

Listen on a MQTT topic ForceFirmwareCheck

johnwalicki, 2020-12-10:
If a device is running for many months it might fall behind on the version of the firmware it is running.
As part of the ESP32 power up / activation process, the board does a firmware version check. If there is a newer firmware version it initiates an OTA firmware update.  That only happens on startup.  A board that has been running for a long time might be stranded on old version.

The sensor could handle this in several ways:
- periodically do a firmware check on its own (once a day or once a week?)
- subscribe to a MQTT topic - lets call it ForceFirmwareCheck - that let's the administrator/device owner to remotely tell a board to check for a firmware update.  That would let us dynamically update sensors if there was a security or software flaw.  We would not need to wait a day or week.

It would be easy to implement, the board already subscribes to other MQTT topics and the callback could be extended with another use case.  The callback would just need to invoke OpenEEWDeviceActivation() function.

johnwalicki, 2020-12-14:
This feature has been implemented in the pending firmware v1.3.0 release

johnwalicki, 2021-02-19:
Firmware v1.3.0 has been published
This Issue has been closed via https://github.com/openeew/openeew-sensor/pull/61

Closed 2021-02-19.

Thread 57 (2020-12-10):

Heartbeat MQTT message

johnwalicki, 2020-12-10:
Today, the sensor sends a MQTT message every second that contains accelerometer data.
If we're getting data, we know the board is alive.
If we implement an edge based STA / LTA algorithm, the sensor will process the accelerometer data at the edge.  If there are no earthquakes, we might not hear from a board for weeks/months.  We won't know its alive.

When we implement STA/LTA edge processing, we should also implement a heartbeat MQTT topic to replace the MQTT data. It does not need to be every second.   The MQTT message would only need to send 1 byte of data.  We can derive the macaddress from the device id (part of the Watson IoT headers).  In the cloud, we could either update the Cloudant record with a last heartbeat timestamp.  The OpenEEW dashboard could read that to indicate status.
There's a Watson IoT Last Event rest api but the dashboard would need to know those credentials.  I could find an example of that implementation too.

Maybe once a minute -  would be 1440 messages/day
Maybe once a hour - would be 24 messages/day

If we're worried about the IBM Cloud Watson IoT Platform lite tier, its limited to 200MB/month so we would want to keep our heartbeats small / sufficiently infrequent.

andygrillo, 2020-12-10:
Doesnt the MQTT broker automatically track devices that are connected to it
? isnt there an inbuilt heartbeat that is used by MQTT which we can simply
read from node-red ?

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

--
Andres Meira
*m* +52 (55) 12246468
*skype *andresmeira

johnwalicki, 2020-12-10:
Yes, Possibly.  There is a Node-RED node to query the status of a device.   I have a flow which can enumerate all of the devices.  It then can iterate across all the devices and get status for each one.  I've never used that technique as a heartbeat.  Will need to experiment to see if I can discover if they are up/down

I see:
payload.status.alert.enabled is either true or false
payload.status.alert.timestamp

johnwalicki, 2020-12-11:
There are other techniques to get the MQTT status of a device.  Will implement this for the OpenEEW Dashboard in a different way.  Saves sending useless messages to the cloud. Closing ticket.

Closed 2020-12-11.

Thread 58 (2021-01-16):

Schematic: custom CP2102N schematic symbol is not included into Sensor_Motion_local.lib

hovercraft-github, 2021-01-16:
The current schematic (both master and version130 branches) uses custom (or outdated) symbol CP2102N-A01-GQFN24
for the U6 part, and this custom symbol is not included into Sensor_Motion_local.lib file, so the schematics diagram looks unreadable in every KiCad instance using an up-to-date schematic symbol libraries.
Although the official KiCad library provides an equivalent schematic symbol in the current repository, it can not be directly substituted because of different geometry.

Please do one of the following:

- put custom CP2102N-A01-GQFN24 symbol into Sensor_Motion_local.lib file
- or (preferably) replace the custom CP2102N-A01-GQFN24 symbol with an equivalent one from the current KiCad repository

perigoso, 2021-01-20:
I'm sorry but I was not able to reproduce your issue.

The symbol is linked to the official Kicad libraries, and has not been modified to my knowledge.

As of version 5.1.9 of Kicad, it's latest stable release, the symbol seems to be linked correctly.

@andygrillo can you take a look at the schematic? It should not matter but I am on a different operating system than windows.

@hovercraft-github can you provide more detail? what operative system, what version of kicad and symbol library, etc.

hovercraft-github, 2021-01-24:
@perigoso Thank you for your attention and support!
Your are right in that the symbol your are using in your schematic is linked to the official Kicad libraries shipped with the version 5.1.9 of Kicad.
But Kicad symbol libraries itself has separate github repository.
It is common practice to update these libraries periodically while they maintain compatibility with the current stable Kicad release,
because of updated and new components they provide.
It looks like that after release of version 5.1.9, the Kicad library maintainers crew decided to remove the CP2102N-A01-GQFN24 symbol from their repository and replace it with an equivalent one with different geometry.
From this on, the problem I described come into play:
anybody who updates his libraries from the Kicad library repository, will get unreadable representation of the CP2102N symbol in openeew-sensor schematic.
At least it happened to me. :)
So, basically it is not an openeew-sensor issue but rather Kicad libraries incompatibility.
Maybe, it would make sense to denote it somewhere in the documentation.

perigoso, 2021-01-24:
This is intended behavior, the master branch of the libraries is not stable, I'm also a contributor there, we try to always be using the latest **stable** release of Kicad and libraries.
You can have both the master and the stable release in parallel in your system fyi.

You're right that this should be documented, could you please open an issue for that?

perigoso, 2021-01-24:
Sorry, don't open an issue, this one is enough, just needs a clearer name

Thread 59 (2021-01-19):

Create firmware variant for standard MQTT broker

andygrillo, 2021-01-19:
To allow for non-Watson IoT connections (eg. Mosquitto MQTT), it would be good to have a variant of the[ Watson IoT firmware](https://github.com/openeew/openeew-sensor/tree/master/firmware/WatsonIoT) that allows it to connect to a generic MQTT broker.

This would allow for connection to any remote or local server running [Mosquitto](https://mosquitto.org/), or another MQTT broker, rather than a specific cloud provider.

johnwalicki, 2021-02-22:
To run an MQTT broker on your local subnet (for instance on a Raspberry Pi), I have made the minimum number of changes to the production firmware via this patch.  Essentially its 3 #ifdefs
Toggle #define LOCALNET in config.h

There's a patch to the version140 branch:
Run a MQTT Broker on a local subnet
https://github.com/openeew/openeew-sensor/commit/df6158a5a825ed4111e3dbc4cf5d02b29ca863e5

johnwalicki, 2021-02-22:
Thanks to @andygrillo  for some inspiration

Closed 2021-02-22.

Thread 60 (2021-02-07):

Accelerometer data to Cloud - Continuous Send vs STA/LTA

johnwalicki, 2021-02-07:
The v1.30 firmware runs silently in STA/LTA mode, just holding a 10 second FIFO queue.
It also subscribes to a MQTT_TOPIC_SENDACCEL topic
```iot-2/cmd/sendacceldata/fmt/json```
which, if published from the Cloud/Dashboard, sends a json object to the sensor:
```
{"LiveDataDuration":<integer>}
```
The device parses this MQTT message:
` numSecsOfAccelReadings = cmdData["LiveDataDuration"].as<int32_t>();`
The device then starts counting down and sending live accelometer data to the cloud. The payload is n seconds of data

Some regional networks / scientists might want a continuous stream of accelerometer data.
This obvious requires more bandwidth and will generate lots of MQTT data.  Someone will have to pay but we can implement the feature.

To keep the code modifications easy, I suggest changing this to an unsigned integer 32 `uint32_t`
That is 4294967295 seconds (which is 136 years or close to 50000 days).  That's sufficiently large!
There would be no other changes to the firmware required.

johnwalicki, 2021-02-07:
@andygrillo Would that be sufficient?

johnwalicki, 2021-02-07:
@vkuna Would that be sufficient?

vkuna, 2021-02-07:
I don't have a strong opinion. If this is an easy solution and it would be easy to change the value remotely, I think it should work just fine.

johnwalicki, 2021-02-07:
Here's how I imagine this working:
- the device checks in when it powers up
- The device mgmt endpoint determines which network this device belongs to and replies to the board with the MQTT broker it should data to.  The board subscribes to a variety of topics (including the sendacceldata topic)
- The device mgmt endpoint also could check a parameter in the device registry (Cloudant) that determines which mode this sensor should operate in (continuous vs STA/LTA)
- The device mgmt endpoint publishes the above message to the device - telling it stream data for max uint seconds.

We might have to worry about timing? What happens to published messages before the device subscribes to the topic?

johnwalicki, 2021-02-07:
Or...
We could create another MQTT topic that "declares" the algorithm that the device should use.
Today, the device firmware implements STA/LTA (local 10 second algorithm) or blindly sending all the accel readings.
Maybe in the future the firmware will implement other seismic algorithms?
We could future proof the firmware so that this potential MQTT topic could tell the device to switch between algorithms.

johnwalicki, 2021-02-07:
At the implementation level for "continuous send mode" it just sets `numSecsOfAccelReadings = 4294967295` seconds.
We would then be able to extend the firmware with whatever else algorithm a seismologist invents.

vkuna, 2021-02-07:
Yes if we can keep that option open it would be great. STA/LTA is a standard and reliable option, however, we want to try some ML detectors deployed on sensors in future. Plus there might be more changes to station functionality, like allowing station to issue 'on-site' warning etc.. All of these would need significant changes to the firmware and we should be able to upgrade all sensors remotely.

andygrillo, 2021-02-08:
I like this 2nd option better because it means the algorithm change can be
done at any time, not only when boot up. \

If I understand correctly, this would allow the change to be done on the
fly via the dashboard.

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

--
Andres Meira
*m* +52 (55) 12246468
*skype *andresmeira

johnwalicki, 2021-02-08:
Without any changes to the firmware, I implemented the following UI change in the OpenEEW Device Mgmt interface:
http://openeew-devicemgmt.mybluemix.net/ui/#!/1

Essentially, its sending the maximum int32_t which is 2147483647 seconds ( ~ 68 years )

andygrillo, 2021-02-08:
looks great!
[image: image.png]

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

--
Andres Meira
*m* +52 (55) 12246468
*skype *andresmeira

johnwalicki, 2021-02-08:
The idea to dynamically change the algorithm is interesting but potentially out of scope for this release.  We currently only have one algorithm.

andygrillo, 2021-02-08:
Sorry my bad description, I just meant change from continuous to triggered,
which it seems you have achieved.

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

--
Andres Meira
*m* +52 (55) 12246468
*skype *andresmeira

johnwalicki, 2021-02-19:
Firmware v1.3.0 is released.
This issue is closed via https://github.com/openeew/openeew-sensor/pull/61

Closed 2021-02-19.

Thread 65 (2021-06-01):

Stops running after reprogramming

neilh10, 2021-06-01:
A device A8032A4DD650 used on a testBoard and is screwed down : after reprogramming it runs successfully.

Works first time after programming,(flash-openeew.sh) it with openeew-firmware151
[flash-openeew.sh.txt](https://github.com/openeew/openeew-sensor/files/6577682/flash-openeew.sh.txt)

but after a power cycle stops jumping to main, just cycles.

[2021-05-26 15:05:24] rst:0x10 (RTCWDT_RTC_RESET),boot:0x16 (SPI_FAST_FLASH_BOOT)
[2021-05-26 15:05:24] configsip: 0, SPIWP:0xee
[2021-05-26 15:05:24] clk_drv:0x00,q_drv:0x00,d_drv:0x00,cs0_drv:0x00,hd_drv:0x00,wp_drv:0x00
[2021-05-26 15:05:24] mode:DIO, clock div:2
[2021-05-26 15:05:24] load:0x3fff0018,len:4
[2021-05-26 15:05:24] load:0x3fff001c,len:1044
[2021-05-26 15:05:24] load:0x40078000,len:10124
[2021-05-26 15:05:24] load:0x40080400,len:5828
[2021-05-26 15:05:24] csum err:0x6c!=0x4d
[2021-05-26 15:05:24] ets_main.c 371
[2021-05-26 15:05:24] ets Jun  8 2016 00:22:57
[2021-05-26 15:05:24]
[2021-05-26 15:05:24] rst:0x10 (RTCWDT_RTC_RESET),boot:0x16 (SPI_FAST_FLASH_BOOT)
[2021-05-26 15:05:24] configsip: 0, SPIWP:0xee
[2021-05-26 15:05:24] clk_drv:0x00,q_drv:0x00,d_drv:0x00,cs0_drv:0x00,hd_drv:0x00,wp_drv:0x00
[2021-05-26 15:05:24] mode:DIO, clock div:2
[2021-05-26 15:05:24] load:0x3fff0018,len:4
[2021-05-26 15:05:24] load:0x3fff001c,len:1044
[2021-05-26 15:05:24] load:0x40078000,len:10124
[2021-05-26 15:05:24] load:0x40080400,len:5828
[2021-05-26 15:05:24] csum err:0x4e!=0x4d
[2021-05-26 15:05:24] ets_main.c 371
[2021-05-26 15:05:24] ets Jun  8 2016 00:22:57

left running, 5hours later still not jumped

[2021-05-26 20:36:30] rst:0x10 (RTCWDT_RTC_RESET),boot:0x16 (SPI_FAST_FLASH_BOOT)
[2021-05-26 20:36:30] configsip: 0, SPIWP:0xee
[2021-05-26 20:36:30] clk_drv:0x00,q_drv:0x00,d_drv:0x00,cs0_drv:0x00,hd_drv:0x00,wp_drv:0x00
[2021-05-26 20:36:30] mode:DIO, clock div:2
[2021-05-26 20:36:30] load:0x3fff0018,len:4
[2021-05-26 20:36:30] load:0x3fff001c,len:1044
[2021-05-26 20:36:30] load:0x40078000,len:10124
[2021-05-26 20:36:30] load:0x40080400,len:5828
[2021-05-26 20:36:30] csum err:0x6d!=0x4d
[2021-05-26 20:36:30] ets_main.c 371

Powered off, tried again a couple of days later

[2021-05-28 11:49:24] rst:0x10 (RTCWDT_RTC_RESET),boot:0x16 (SPI_FAST_FLASH_BOOT)
[2021-05-28 11:49:24] configsip: 0, SPIWP:0xee
[2021-05-28 11:49:24] clk_drv:0x00,q_drv:0x00,d_drv:0x00,cs0_drv:0x00,hd_drv:0x00,wp_drv:0x00
[2021-05-28 11:49:24] mode:DIO, clock div:2
[2021-05-28 11:49:24] load:0x3fff0018,len:4
[2021-05-28 11:49:24] load:0x3fff001c,len:1044
[2021-05-28 11:49:24] load:0x40078000,len:10124
[2021-05-28 11:49:24] load:0x40080400,len:5828
[2021-05-28 11:49:24] csum err:0x49!=0x4d
[2021-05-28 11:49:24] ets_main.c 371
[2021-05-28 11:49:25] ets Jun  8 2016 00:22:57
[2021-05-28 11:49:25]
[2021-05-28 11:49:25] rst:0x10 (RTCWDT_RTC_RESET),boot:0x16 (SPI_FAST_FLASH_BOOT)
[2021-05-28 11:49:25] configsip: 0, SPIWP:0xee
[2021-05-28 11:49:25] clk_drv:0x00,q_drv:0x00,d_drv:0x00,cs0_drv:0x00,hd_drv:0x00,wp_drv:0x00
[2021-05-28 11:49:25] mode:DIO, clock div:2
[2021-05-28 11:49:25] load:0x3fff0018,len:4
[2021-05-28 11:49:25] load:0x3fff001c,len:1044
[2021-05-28 11:49:25] load:0x40078000,len:10124
[2021-05-28 11:49:25] load:0x40080400,len:5828
[2021-05-28 11:49:25] csum err:0x69!=0x4d
[2021-05-28 11:49:25] ets_main.c 371
[2021-05-28 11:49:25] ets Jun  8 2016 00:22:57

[2021-05-28 11:49:24] ets Jun  8 2016 00:22:57

johnwalicki, 2021-06-01:
Hi Neil - This ticket is potentially opened in the wrong repo.  OpenEEW firmware is discussed over in the
https://github.com/openeew/openeew-firmware
repository.

I suggest that you try to flash the board again.  Its not booting at all. Grab the binaries from here:
https://github.com/openeew/openeew-firmware/releases/download/1.5.0/openeew-firmware150.zip

neilh10, 2021-06-01:
Hi John. I put it here because it seems like it is at base board support level or at an (embedded?) flash.
I flashed it three times, (edited above) with openeew-firmware151 and it works until it power cycles.
The other two boards are good with flashing openeew-firmware151.

So are you suggesting regressing back to openeew-firmware150 to see if that makes a difference?

johnwalicki, 2021-06-01:
I wasn't advocating for v1.5.0 vs v1.5.1 binaries.  It was just the easiest link I could send you.
Would be easier to watch the serial terminal and diagnose what's happening to your boards.
If you think you can share them via a WebEx, I'll send you a link.

neilh10, 2021-06-01:
I have it setup connected through a powered USB Hub to  a riPi4/Ubuntu - so could try WebEx.

neilh10, 2021-06-01:
I was able to reprogram it with openeew-firmware151, with John watching/cell, add it to the network and it booted.
It then was able to access WiFi, and also 1G network, but not my 8 Port 10/100Mbit router.
I rebooted a couple of times, and it came up every time. John reset it remotely a couple of times and it came up every time.
Closing - as this device A8032A4DD650  is now reprogrammed OK.

Closed 2021-06-01.

Thread 66 (2021-06-01):

Doesn't work with all ethernet routers

neilh10, 2021-06-01:
Two openEEW sensors I have only work with some ethernet routers

Device AB032A4DCCCC I use in my office  ,
 works OK with D-link 1Gigbit 16 channel
problems with D-link 10/100M 16Channel and other  8-port 10/100 Mbit routers

Device A8032A4DCCB4 (testBoard screwed down):
works with tplink AC1750 Wireless Dual Band Gigabit Router
non working ethernet against my standard workshop 18-port 10/100 Mbit  router that works with the above tplink AC1750 and rPi devices.
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

https://www.microchip.com/wwwproducts/en/LAN8710A says it works with 10BASE-T/100BASE-TX transceivers

johnwalicki, 2021-06-01:
Hi Neil - This ticket is potentially opened in the wrong repo. OpenEEW firmware is discussed over in the
https://github.com/openeew/openeew-firmware
repository.

For certain, your boards are experiencing odd ethernet behavior.

I've only tested my boards with a TP-Link 1GB ethernet switch.

The firmware is using the standard Arduino / Espressif ESP32 ethernet library.  Its not doing anything special to it.
~/.platformio/packages/framework-arduinoespressif32/libraries/WiFi/src/ETH.h

johnwalicki, 2021-06-01:
Looking for a pattern in your ethernet switch / router network configurations, it seems the board and ethernet is working with relatively modern 1Gb routers / switches but fails with older 10/100 switches.

I'll dig around for an old 10/100 ethernet switch to test.

johnwalicki, 2021-06-01:
I plugged my (new) OpenEEW device into a DLink 10/100 Ethernet switch:
```
Waiting for Ethernet to start...
Waiting for Ethernet to start...
Waiting for Ethernet to start...
ETH Disconnected
Waiting for Ethernet to start...
Waiting for Ethernet to start...
Waiting for Ethernet to start...
Waiting for Ethernet to start...
ETH Connected
Waiting for Ethernet to start...
Waiting for Ethernet to start...
```

neilh10, 2021-06-01:
Hi John, I put it here because its not clear if its a hardware issue or a firmware issue.
Looks like you are getting the same response .....  good to duplicate....
As the https://www.microchip.com/wwwproducts/en/LAN8710A  says it should work with 10/100 - but its actually only worked for me on 1G routers . Possibly suggests that the 1G routers are compensating for something not working.
Practically  Arduino / Espressif ESP32  is a "teaching" principles - not drowning in the historical detail.
https://en.wikipedia.org/wiki/IEEE_802.11

Traditionally, for a commercial product, the process is define all the IEEE 802.11 standards it needs to work to, and then probably buy some expensive test equipment that will run a regression test.

This is a bit of statistical method  ~ a few pieces of equipment that work with other equipment.

I can move it to firmware if you think there is a firmware solution.

johnwalicki, 2021-06-01:
Neil and I ran some live experiments.  I was able to find 4 old 10/100 Ethernet switches.  On two (identical models) DLink 10/100 DS-55+ the ESP32 device would just loop forever waiting for the Ethernet to get an IP address.  Two other devices (NetGear 8 port 10/100 FS108) and a DLink DI-524 10/100 router, the ESP32 got an Ethernet address and proceeded through its initialization correctly.

For certain, there is a problem with some old 10/100 Ethernet switch hardware.

It does point out an unlikely scenario / bug in the firmware.  In v1.5.1 or lower, it gets stuck in a while() loop waiting for an Ethernet address.  I've created a firmware patch that will only wait 10 seconds for an IP Address. If it doesn't get an IP address on the Ethernet interface, it exits the while loop and proceeds through the rest of the initialization .

Here's a snip of the behavior with the new patch described above:
```
OpenEEW Sensor Application
ETH Started
ETH Connected
Waiting for Ethernet to start...
Waiting for Ethernet to start...
Waiting for Ethernet to start...
Waiting for Ethernet to start...
Waiting for Ethernet to start...
Waiting for Ethernet to start...
Waiting for Ethernet to start...
Waiting for Ethernet to start...
Waiting for Ethernet to start...
Waiting for Ethernet to start...
Waiting for Ethernet to start...
Waiting for Ethernet to start...
Waiting for Ethernet to start...
Waiting for Ethernet to start...
Waiting for Ethernet to start...
Waiting for Ethernet to start...
Waiting for Ethernet to start...
Waiting for Ethernet to start...
Waiting for Ethernet to start...
Waiting for Ethernet to start...
ESP32 WiFi interface ready
Stored networks : 1
ESP32 WiFi started
Completed scan for access points
WiFi Network scan done
8 network(s) found
1: wyndwpa (-23)
2: wynd565o (-56)*
3: 565guest (-56)*
ESP32 WiFi interface ready
Reading stored networks from NVM
ESP32 WiFi started
ESP32 WiFi started
```

perigoso, 2022-03-03:
Have any of you tried with different cables? A straight through cable would be the correct one i believe, but do try with a crossover too, nowadays hardware deals with the crossover automatically but this wasn't always the case.

johnwalicki, 2022-03-03:
We eventually agreed that there is a problem with some old 10/100 Ethernet switch hardware.    I tried multiple routers. See tests above.
Closing issue.

Closed 2022-03-03.

Thread 68 (2021-12-29):

Create simple board on JLCPCB/PCBWay with ESP32+ADXL345+Neopixel

andygrillo, 2021-12-29:
This basic board would not have ethernet or the more expensive ADXL355, but would allow users to get started, and also densify networks.

Thread 69 (2022-04-03):

broken URL in readme

sknebel, 2022-04-03:
The link to the blog post in the first sentence of the readme is 404: https://openeew.com/blog/sensor-benchmark, and from a quick look over the site I couldn't find a new URL.

sergeant82d, 2022-04-03:
It looks to me like the whole project is stalled. I'd love to get a sensor and get it online, but if the network is not working... What's the point?

andygrillo, 2022-04-04:
Hi @sergeant82d , yes we (grillo) are developing behind the scenes some updates including a neural network detection system. Soon this will be published here.

FYI for sometime OpenEEW had stopped being a global network for anyone to plug in to. We had decided as a community that instead we would provide folks the tools to host their own EEW network. This is because we realized a global network would never achieve the density necessary.

sergeant82d, 2022-04-04:
Ahh. Okay, that makes sense. I looked for the information on setting up a network once, but it was missing. Is the local network setup information available now? Any idea if or when the assembled units will be available again? Thanks!
