openeew/openeew-sensor/pcb/openeew-schematic.pdf

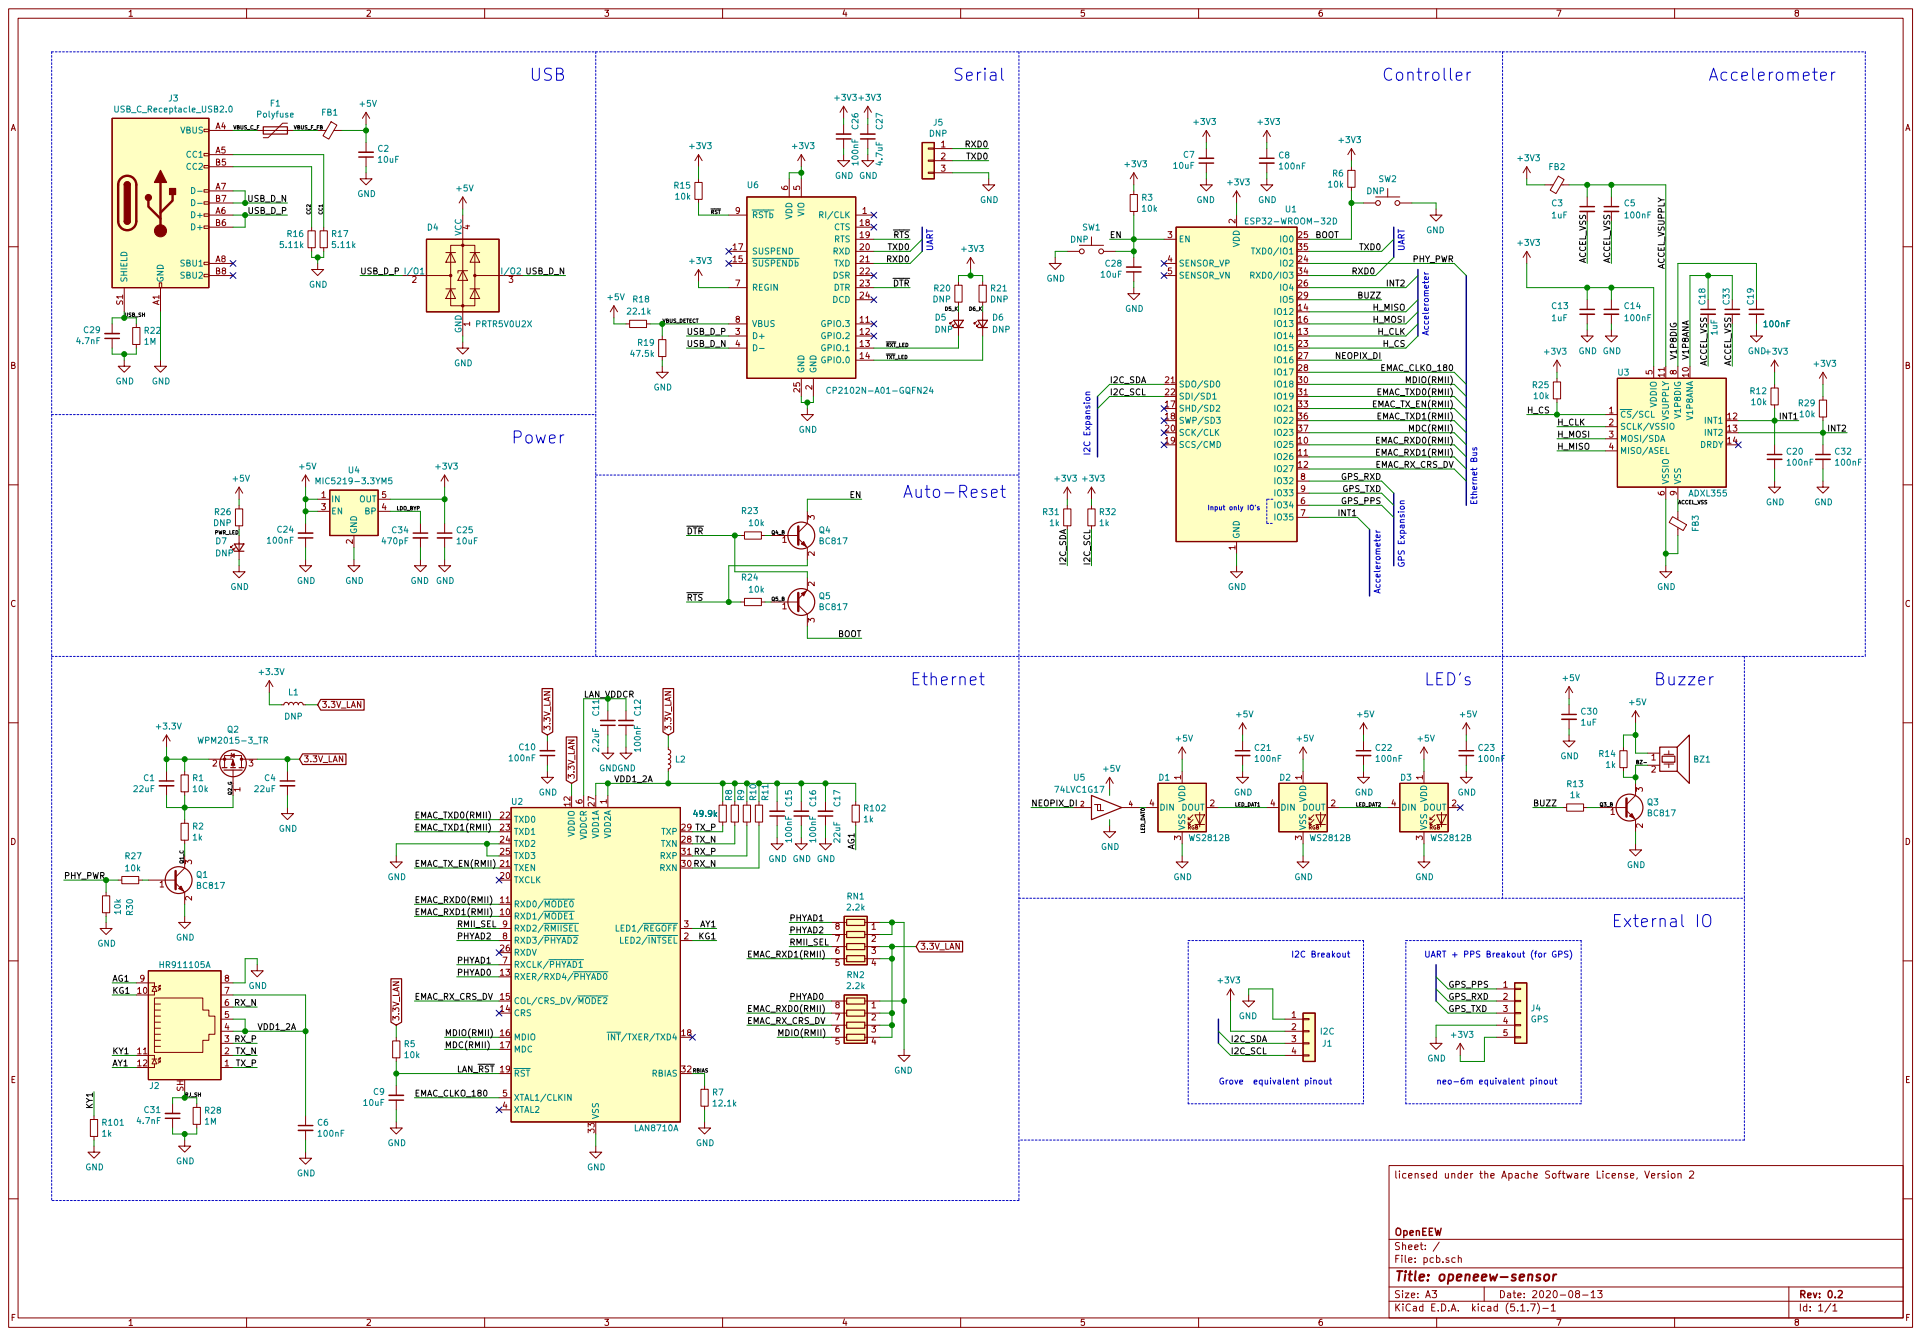
[picture p14: page 1]

6 REGIN 7 VBUS 8 RSTb 9 U6 CP2102N-A01-GQFN24 GND 10k R30 R23

2 3 Q4BC817 R21 DNP R20 DNP D5 DNP D6 DNP GND GND GND

2 EN 3 BP 4 OUT 5 U4 MIC5219-3.3YM5 +3V3 RI/CLK 1 GPIO.3 11 GPIO.2 12 GPIO.1 13 GPIO.0 14 SUSPENDb 15 SUSPEND 17 CTS 18 RTS 19 GND

2 RXD 20 TXD 21 DSR 22 DTR 23 DCD 24 GND 25 D+ 3 D- 4 VIO

2 SCK/CLK 20 SDO/SD0 21 SDI/SD1 22

INT2 UART + PPS Breakout (for GPS) UART
TXD0 DTR

GND GND C17 22uF GND GND C16 100nF GND1

Auto-Reset

1 RXD1/MODE1 10 RXD0/MODE0 11 VDDIO 12 RXER/RXD4/PHYAD0 13 CRS 14 COL/CRS_DV/MODE2 15 MDIO 16 MDC 17

I2C Breakout Grove equivalent pinout

licensed under the Apache Software License, Version 2

File: pcb.sch Sheet: / OpenEEW

Id: 1/1 Title: openeew-sensor
