openeew/openeew-sensor/(commit log)

2020-08-09 firmware add
    [min_spiffs.csv]
2020-08-09 Change sensor name
2020-08-12 eagle files
    [OpenEEW sensor board - ethernet.brd, OpenEEW sensor board - ethernet.sch]
2020-08-13 change SPI pins
2020-08-13 gitignore: setup kicad ignores
2020-08-13 pcb: kicad project creation
    [pcb.kicad_pcb, pcb.sch]
2020-08-13 schematic: ported schematic from legacy eagle schematic
    [pcb.sch]
2020-08-13 libs: added local footprint library for LCC-14 (ADXL355) and 17mm buzzer
2020-08-13 pcb: footprint association of the components
    [pcb.sch]
2020-08-13 libs: added local footprint library for JST connector (HW4-SMD-2.0)
2020-08-13 pcb: small fixups
    [pcb.sch]
2020-08-13 pcb: import outline from legacy eagle project, located main components acording to legacy eagle project
    [pcb.kicad_pcb]
2020-08-13 move files
    [OpenEEW sensor board - ethernet.brd, OpenEEW sensor board - ethernet.sch]
2020-08-13 added legacy folder with eagle pcb files
    [OpenEEW sensor board - ethernet.brd, OpenEEW sensor board - ethernet.sch]
2020-08-19 fix #8
    [pcb.sch]
2020-08-30 new 3d case
    [openeew-enclosure.f3d, sensor_pcb_outline.dxf]
2020-08-31 hw-sch: changed neopixel data level shifting
    [pcb.sch]
2020-08-31 hw-sch: changed buzzer driving circuit
    [pcb.sch]
2020-09-23 sch: add USB-C power
    [pcb.sch]
2020-09-23 sch: USB-C Programming and reorganization
    [pcb.sch]
2020-09-23 fix: #17, accelerometer power
    [pcb.sch]
2020-09-29 Attach the Interrupt using digitalPinToInterrupt()
2020-10-07 Schematic final candidate
    [pcb.sch]
2020-10-09 footprint association
    [pcb.sch]
2020-10-09 change LDO for MIC5219 ultra low noise ldo sot-23-5
    [pcb.sch]
2020-10-09 add UART breakout points to bypass USB-Serial Chip
    [pcb.sch]
2020-10-09 fix SOT-143 footprint locall\y
    [pcb.sch]
2020-10-09 Labels added
    [pcb.sch]
2020-10-09 Added pull-ups on I2C
    [pcb.sch]
2020-10-09 schematic fixups and buzzer package change
    [pcb.sch]
2020-10-09 layout component placement
    [pcb.kicad_pcb]
2020-10-09 Define design rules, add mounting hole
    [pcb.kicad_pcb]
2020-10-15 Layout route ethernet
    [pcb.kicad_pcb, pcb.sch]
2020-10-15 layout add missing VDD1_2A power trace
    [pcb.kicad_pcb]
2020-10-21 layout route buzzer circuit
    [pcb.kicad_pcb]
2020-10-21 layout route usb serial circuit
    [pcb.kicad_pcb, pcb.sch]
2020-10-21 layout route accelerometer circuit
    [pcb.kicad_pcb]
2020-10-21 layout route missing boot0 line
    [pcb.kicad_pcb]
2020-10-21 layout route phy_pwr
    [pcb.kicad_pcb]
2020-10-21 layout ethernet fixups
    [pcb.kicad_pcb, pcb.sch]
2020-10-21 layout route neopix
    [pcb.kicad_pcb]
2020-10-21 layout route missing power led line
    [pcb.kicad_pcb]
2020-10-21 layout route expansion ports
    [pcb.kicad_pcb]
2020-10-23 layout route power, reroute ethernet leds
    [pcb.kicad_pcb, pcb.sch]
2020-10-23 layout gnd plane via stitching
    [pcb.kicad_pcb]
2020-10-24 Add silkscreen
    [pcb.kicad_pcb]
2020-10-24 OpenEEW Firmware for Watson IoT
    [min_spiffs.csv]
2020-11-13 OpenEEW Device Activation
2020-11-14 Handle Device Activation failures
2020-11-15 Report Device Geo Coordinates
2020-11-20 Blink NeoPixel LED Status stages
2020-11-23 Whitespace and print LED stages
2020-11-23 Changelog: Removed vias conflicting with traces moved vias conflicting with AG1 moved connectos so the are 1.7 mm outside board labeled components as DNP Swaped trace thickness in power regulator tra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
    [pcb.kicad_pcb, pcb.sch]
2020-11-24 ADXL Interrupt Pin production board change
2020-11-24 Blink LED on MQTT data send
2020-11-24 ADXL Interrupt Pin production board
2020-11-24 change ETH Power Pin > GPIO2
2020-11-25 Fix Ethernet circuit transformer center tap should connect to VDD1_2A (3V3)
    [pcb.kicad_pcb, pcb.sch]
2020-11-25 Load Server PEM chain from SPIFFS
2020-12-06 openeew-devicemgt endpoint
2020-12-06 History of ADXL355 fork
    The ADXL355 header and source are a fork from
    https://github.com/markrad/esp32-ADXL355
    created by Mark Radbourne, a former contributor to Grillo
    Converted from I2C to SPI
    Relicensed from MIT to Apache Public Licence v2
2020-12-09 new enclosure files for 0.2v board
    [openeew enclosure bottom.stl, openeew enclosure lid.stl, sensor enclosure bottom with bubble level.step, sensor enclosure bottom.step, sensor enclosure top.step]
2020-12-09 new readme for 3d printing
2020-12-09 new 3d print images
2020-12-13 Switch from WiFi to Ethernet
2020-12-24 Slow breathe LEDs while reading Accelerometer
2021-02-28 new sensor images
2021-02-28 pcb image new
2021-02-28 updated pcb image
2021-03-11 Switch to device-mgmt.openeew.com
2021-03-19 discard the first samples out of the accelerometer
2021-05-12 remove firmware and enclosure (now on thingiverse)
    [min_spiffs.csv, openeew enclosure bottom.stl, openeew enclosure lid.stl]
2021-11-11 Update README.md
    https://forum.kicad.info/t/warning-avoid-all-links-to-kicad-pcb-org-use-kicad-org/31521
