openeew/openeew-sensor/(notices)

Notices in the files:
parts and their libraries:
andylib: COPYRIGHT: Copyright (C) 2018 Accelerated Designs. All rights reserved
